govindak-umd/Bachelor-s-in-Technology-FINAL-PROJECT/stepper_NEWTEST.ino

/*
 Stepper Motor Control - one revolution

 This program drives a unipolar or bipolar stepper motor.
 The motor is attached to digital pins 8 - 11 of the Arduino.

 The motor should revolve one revolution in one direction, then
 one revolution in the other direction.


 Created 11 Mar. 2007
 Modified 30 Nov. 2009
 by Tom Igoe

 */

#include <Stepper.h>

const int stepsPerRevolution = 200;  // change this to fit the number of steps per revolution
// for your motor

// initialize the stepper library on pins 8 through 11:
Stepper myStepper(stepsPerRevolution, 8, 9, 11, 10);

void setup() {
  pinMode(2,OUTPUT);
  pinMode(3,OUTPUT);
  // set the speed at 60 rpm:
  myStepper.setSpeed(60);
  // initialize the serial port:
  Serial.begin(9600);
}

void loop() {
  // step one revolution  in one direction:
  Serial.println("clockwise");
  digitalWrite(3,HIGH);
  digitalWrite(2,HIGH);
  myStepper.step(64);
  delay(465);
  digitalWrite(3,LOW);
  digitalWrite(2,LOW);
  delay(4000);

  // step one revolution in the other direction:
  Serial.println("counterclockwise");
  digitalWrite(3,HIGH);
  digitalWrite(2,HIGH);
  myStepper.step(-128);
  delay(920);
  digitalWrite(3,LOW);
  digitalWrite(2,LOW);
  delay(4000);

 digitalWrite(3,HIGH);
  digitalWrite(2,HIGH);
  myStepper.step(64);
  delay(460);
  digitalWrite(3,LOW);
  digitalWrite(2,LOW);
  delay(4000);
}
